Surgical-Lighting-MIT-2-75-2024/SurgicalLightMCUModule/Rev B/MCUModule.kicad_pcb

## KiCad design Rev B/MCUModule.kicad_pcb (2024-04-24)

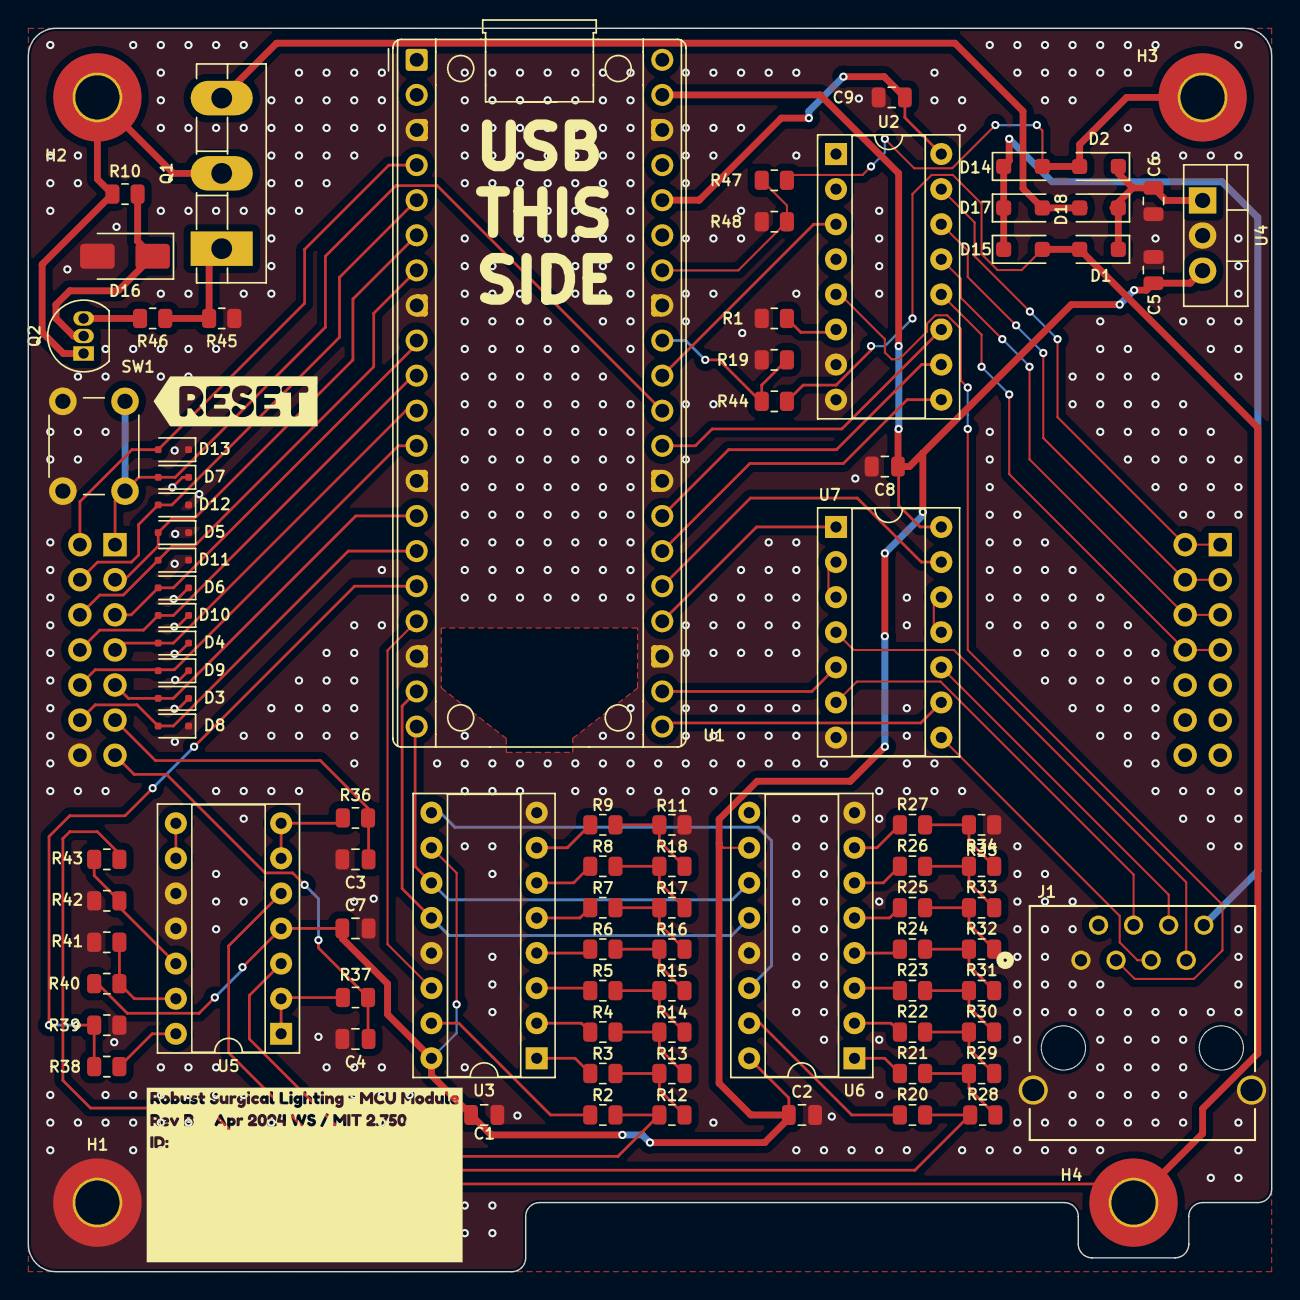
[picture p1: board MCUModule.kicad_pcb from above]

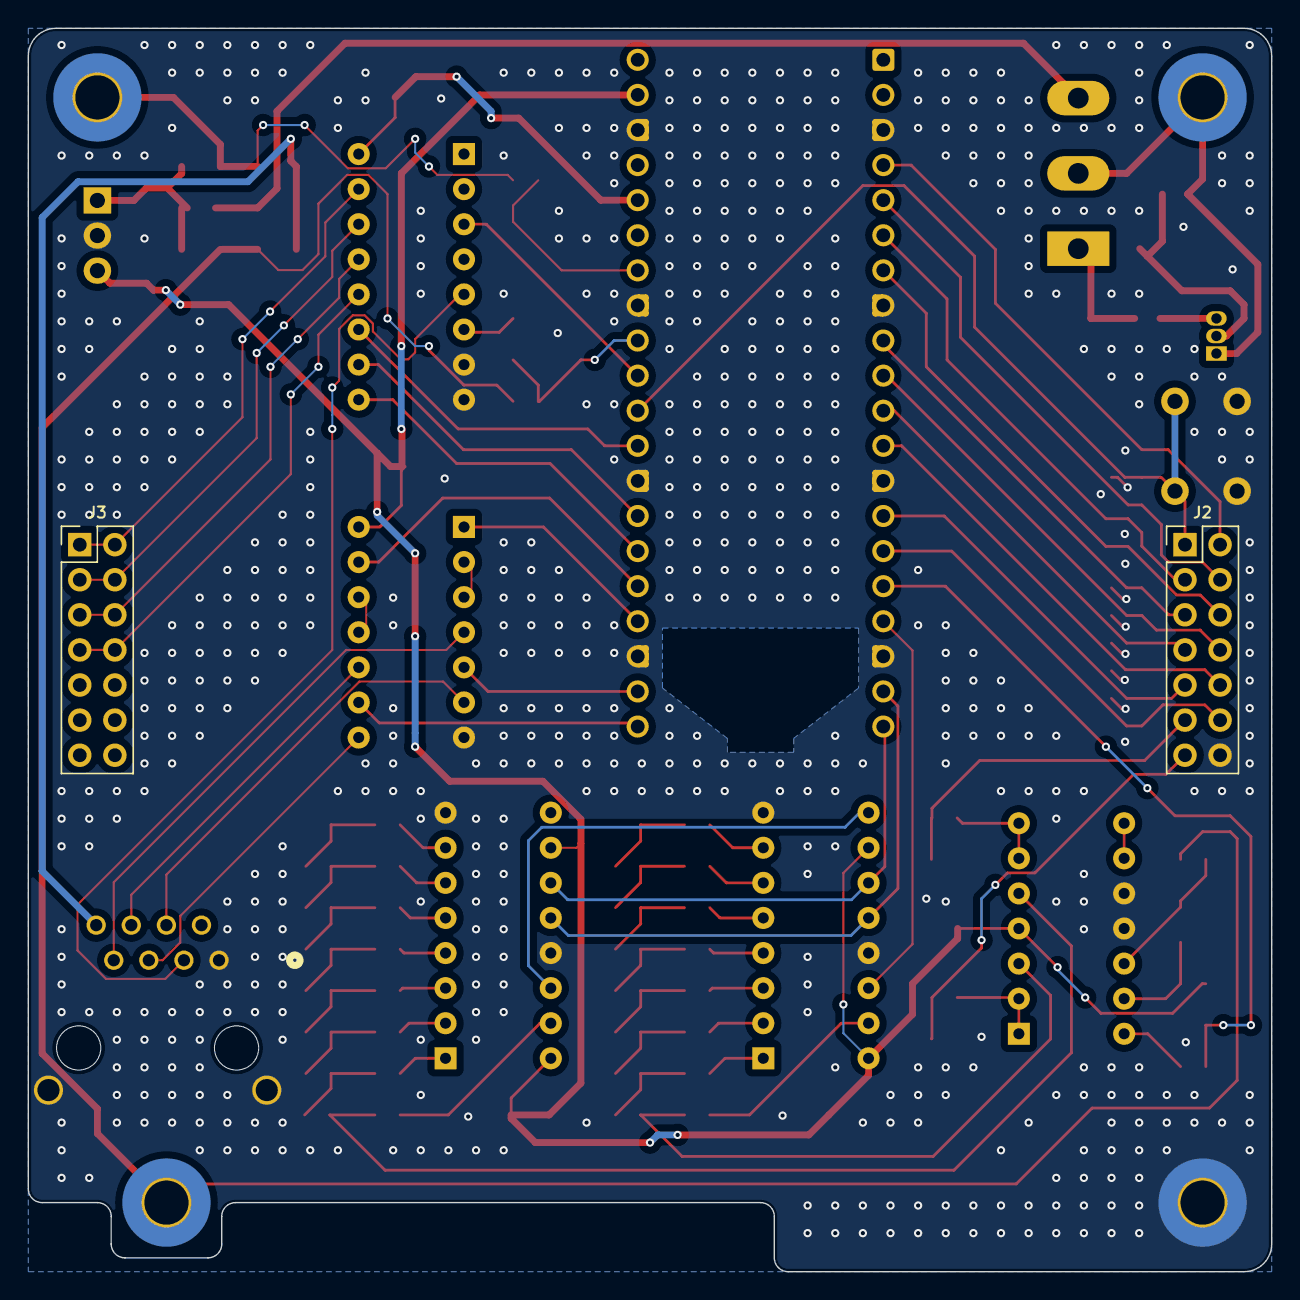
[picture p2: board MCUModule.kicad_pcb from below]

Board: 2 copper layers, 90.0 x 90.0 mm, 94 parts (2 on the bottom side), 90 nets.

Parts:
C1, C2, C7, C8, C9: 100nF 50V,X7R; C_0805_2012Metric
C3, C4, C5, C6: 1uF 50V,X7R; C_0805_2012Metric
D1, D2, D14, D15, D17, D18: 1N5819W; D_SOD-123F
D3, D4, D5, D6, D7, D8, D9, D10, D11, D12, D13: PESD3V3L1BA,115; D_SOD-323F
D16: SMAZ15Z-13-F; D_SMA
H1, H2, H3, H4: M3 Hole; MountingHole_3.2mm_M3_Pad_TopBottom
J1: RJ45_Shielded; CONN_A-2014-2S-4-N-R_ASM
J2, J3: 2x7 P2.54mm; PinHeader_2x07_P2.54mm_Vertical
Q1: TIP35C; TO-3PB-3_Vertical
Q2: BC337; TO-92_Inline
R1: 0; R_0805_2012Metric
R2, R3, R4, R5, R6, R7, R8, R9, R11, R20, R21, R22, R23, R24, R25, R26, R27, R35: 20k; R_0805_2012Metric
R10, R12, R13, R14, R15, R16, R17, R18, R19, R28, R29, R30, R31, R32, R33, R34, R39, R40, R41, R42, R46, R48: 10k; R_0805_2012Metric
R36, R37: 1k; R_0805_2012Metric
R38: 4.7k; R_0805_2012Metric
R43, R45: 27k; R_0805_2012Metric
R44, R47: 33k; R_0805_2012Metric
SW1: SW_SPST; SW_PUSH_6mm
U1: RaspberryPi_Pico; RaspberryPi_Pico_Common_THT
U2: 74HC4051; DIP-16_W7.62mm_Socket
U3, U6: 74HC595; DIP-16_W7.62mm_Socket
U4: LM7805_TO220; TO-220-3_Vertical
U5: LM324; DIP-14_W7.62mm_Socket
U7: 74HC14; DIP-14_W7.62mm_Socket
kibuzzard-6626A9C6: G***; kibuzzard-6626A9C6
kibuzzard-662436D7: G***; kibuzzard-662436D7

Connections:
+3.3V: C9.1, U1.36 (3V3), U2.16 (VCC)
+5V: C1.1, C2.1, C5.1, C7.1, C8.1, R40.2, U1.39 (VSYS), U3.10 (~SRCLR), U3.16 (VCC), U4.3 (VO), U5.4 (V+), U6.10 (~SRCLR), U6.16 (VCC), U7.14 (VCC)
/11V_SOLAR: D17.2 (A), D18.2 (A), Q1.3 (E)
/12V_Battery: D2.2 (A), D14.2 (A), H3.1, R47.2
/12V_Wall: D1.2 (A), D15.2 (A), H4.1, R43.1, R44.2
/12V_Wall_Bad: R38.2, R39.1, U1.16 (GPIO12)
/15V_SOLAR: Q1.1 (B), R45.2, R46.1
/AnalogMuxOut: U1.31 (GPIO26_ADC0), U2.3 (A)
/BatChgEna1: D4.2 (A2), J2.7, U1.11 (GPIO8)
/BatChgEna2: D3.2 (A2), J2.9, U1.14 (GPIO10)
/BoostEna1: D5.2 (A2), J2.3, U1.6 (GPIO4)
/BoostEna2: D6.2 (A2), J2.5, U1.9 (GPIO6)
/BoostVoltage_0.1x: J3.7, J3.8, U2.12 (A3)
/DATA_5V: J1.7, U7.4
/DATA_DAC: U1.17 (GPIO13), U3.14 (SER)
/DATA_DISPLAY: U1.24 (GPIO18), U7.1
/DIM: J1.3, U2.5 (A5)
/DisableBackupPico: D13.2 (A2), J2.2, U1.4 (GPIO2)
/IRef_Buck: C3.1, J2.11, R36.2
/LightISense1: J3.5, J3.6, U2.13 (A0)
/LightISense2: J3.3, J3.4, U2.14 (A1)
/ModuleENA: D7.2 (A2), J2.1, SW1.2 (B), U1.30 (RUN)
/Mux2: J3.1, J3.2, U2.15 (A2)
/OE_5V: J1.4, U7.6
/OE_DISPLAY: U1.22 (GPIO17), U7.5
/PWM_Lights1: D10.2 (A2), J2.8, U1.10 (GPIO7)
/PWM_Lights2: D9.2 (A2), J2.10, U1.12 (GPIO9)
/PowerModuleEna1: D12.2 (A2), J2.4, U1.5 (GPIO3)
/PowerModuleEna2: D11.2 (A2), J2.6, U1.7 (GPIO5)
/RCLK_5V: J1.5, U7.8
/RelaySelectHighPreference: D8.2 (A2), J2.12, U1.15 (GPIO11)
/S0: U1.29 (GPIO22), U2.11 (S0)
/S1: U1.27 (GPIO21), U2.10 (S1)
/S2: U1.26 (GPIO20), U2.9 (S2)
/SOLAR: H2.1, Q1.2 (C), Q2.1 (C), R10.1
/SRCLK_5V: J1.6, U7.10
/SRCLK_DISPLAY: U1.25 (GPIO19), U7.13
/Shift Register Based DAC 0/AnalogOut_Unbuffered: R2.2, R12.1, U5.3 (+)
/Shift Register Based DAC 0/DataOut: U3.9 (QH'), U6.14 (SER)
/Shift Register Based DAC 1/AnalogOut_Unbuffered: R20.2, R28.1, U5.5 (+)
/VRef_Buck: C4.1, J2.13, R37.2
/~RCLK_DISPLAY: U1.21 (GPIO16), U7.9
GND: C1.2, C2.2, C3.2, C4.2, C5.2, C6.2, C7.2, C8.2, C9.2, D3.1 (A1), D4.1 (A1), D5.1 (A1), D6.1 (A1), D7.1 (A1), D8.1 (A1), D9.1 (A1), D10.1 (A1), D11.1 (A1), D12.1 (A1), D13.1 (A1), D16.2 (A), H1.1, J1.1, J1.SH, J2.14, R1.2, R11.1, R19.1, R35.1, R39.2, R41.2, R42.2, R45.1, R48.1, SW1.1 (A), U1.3 (GND), U1.8 (GND), U1.13 (GND), U1.18 (GND), U1.23 (GND), U1.28 (GND), U1.33 (AGND), U1.38 (GND), U2.7 (VEE), U2.8 (GND), U3.8 (GND), U3.13 (~OE), U4.2 (GND), U5.10 (+), U5.11 (V-), U6.8 (GND), U6.13 (~OE), U7.7 (GND)
unnamed: C6.1, D1.1 (K), D2.1 (K), D18.1 (K), U4.1 (VI)
unnamed: D14.1 (K), D15.1 (K), D17.1 (K), J1.8
unnamed: D16.1 (K), Q2.2 (B), R10.2
unnamed: Q2.3 (E), R46.2
unnamed: R9.2, R11.2, R18.2
unnamed: R3.2, R12.2, R13.1
unnamed: R4.2, R13.2, R14.1
unnamed: R5.2, R14.2, R15.1
unnamed: R6.2, R15.2, R16.1
unnamed: R7.2, R16.2, R17.1
unnamed: R8.2, R17.2, R18.1
unnamed: R21.2, R28.2, R29.1
unnamed: R22.2, R29.2, R30.1
unnamed: R23.2, R30.2, R31.1
unnamed: R24.2, R31.2, R32.1
unnamed: R25.2, R32.2, R33.1
unnamed: R26.2, R33.2, R34.1
unnamed: R27.2, R34.2, R35.2
unnamed: R38.1, U5.14
unnamed: R19.2, R44.1, U1.32 (GPIO27_ADC1)
unnamed: R47.1, R48.2, U1.34 (GPIO28_ADC2)
unnamed: R1.1, U2.6 (~E)
unnamed: R2.1, U3.15 (QA)
unnamed: R3.1, U3.1 (QB)
unnamed: R4.1, U3.2 (QC)
unnamed: R5.1, U3.3 (QD)
unnamed: R6.1, U3.4 (QE)
unnamed: R7.1, U3.5 (QF)
unnamed: R8.1, U3.6 (QG)
unnamed: R9.1, U3.7 (QH)
unnamed: R37.1, U5.1, U5.2 (-)
unnamed: R36.1, U5.6 (-), U5.7
unnamed: U5.8, U5.9 (-)
unnamed: R42.1, R43.2, U5.12 (+)
unnamed: R40.1, R41.1, U5.13 (-)
unnamed: R20.1, U6.15 (QA)
unnamed: R21.1, U6.1 (QB)
unnamed: R22.1, U6.2 (QC)
unnamed: R23.1, U6.3 (QD)
unnamed: R24.1, U6.4 (QE)
unnamed: R25.1, U6.5 (QF)
unnamed: R26.1, U6.6 (QG)
unnamed: R27.1, U6.7 (QH)
unnamed: U7.2, U7.3
unnamed: U7.11, U7.12
RCLK_DAC: U1.19 (GPIO14), U3.12 (RCLK), U6.12 (RCLK)
SRCLK_DAC: U1.20 (GPIO15), U3.11 (SRCLK), U6.11 (SRCLK)
