Surgical-Lighting-MIT-2-75-2024/SurgicalLightMCUModule/Firmware/LampFirmware/pinouts.h

#ifdef REV_A01

#define RCLK_DISPLAY 16
#define OE_DISPLAY 17
#define DATA_DISPLAY 18
#define SRCLK_DISPLAY 19

#define RCLK_DAC 14
#define DATA_DAC 15
#define SRCLK_DAC 13

#define MUX_S0 22
#define MUX_S1 21
#define MUX_S2 20
#define MUX_ADC 26

#define BRIGHTNESS_POT_CHANNEL 3
#define SOLAR_SENSE_CHANNEL 5

#define RELAY 11

#define PWM1 7
#define WallBadINT 12
#define WallSense 27
#define BatterySense 28

#endif

#ifdef REV_B01

#define RCLK_DISPLAY 16
#define OE_DISPLAY 17
#define DATA_DISPLAY 18
#define SRCLK_DISPLAY 19

#define RCLK_DAC 14
#define DATA_DAC 13
#define SRCLK_DAC 15

#define MUX_S0 22
#define MUX_S1 21
#define MUX_S2 20
#define MUX_ADC 26

#define BRIGHTNESS_POT_CHANNEL 5
#define SOLAR_SENSE_CHANNEL 3

#define RELAY 11

#define PWM1 7
#define WallBadINT 12
#define WallSense 27
#define BatterySense 28

#endif
