Surgical-Lighting-MIT-2-75-2024/SurgicalLightMCUModule/Firmware/LampFirmware/Display.h

#if defined REV_A01 || defined REV_B01

uint8_t DISPLAY_BITS[10] = {
  0b00111111, //0
  0b00110000, //1
  0b01011011, //2
  0b01111001, //3
  0b01110100, //4
  0b01101101, //5
  0b01101111, //6
  0b00111000, //7
  0b01111111, //8
  0b01111101  //9
};



#define DISPLAY_BITS_COLON 0b11
#define DISPLAY_BITS_AC_PWR 1 << 6
#define DISPLAY_BITS_SOLAR_PWR 1 << 5
#define DISPLAY_BITS_BATTERY_PWR 1 << 4
#define DISPLAY_BITS_WARNING 1 << 3
#define DISPLAY_BITS_FAILURE 1 << 2

#endif
