Surgical-Lighting-MIT-2-75-2024/SurgicalLightMCUModule/(commit log)

2024-03-20 Started schematic
    [DAC.kicad_sch, MCUModule.kicad_pcb, MCUModule.kicad_sch]
2024-03-27 Edit File Folders to reflect Revisioning Standards
    [DAC.kicad_sch, MCUModule.kicad_pcb, MCUModule.kicad_sch]
2024-03-29 added more schematic stuffs
    [DAC.kicad_sch, MCUModule.kicad_sch]
2024-04-03 updated BOM
    [DAC.kicad_sch, MCUModule.kicad_sch]
2024-04-18 added power module support
2024-05-08 fixed pinouts + battery cap calc
    [LampFirmware.ino, pinouts.h]
2024-05-08 updated code to work with buck setpoint control
